yijeongsoo/Smart_Bookstand/SmartBookstand/docs/schematic.pdf

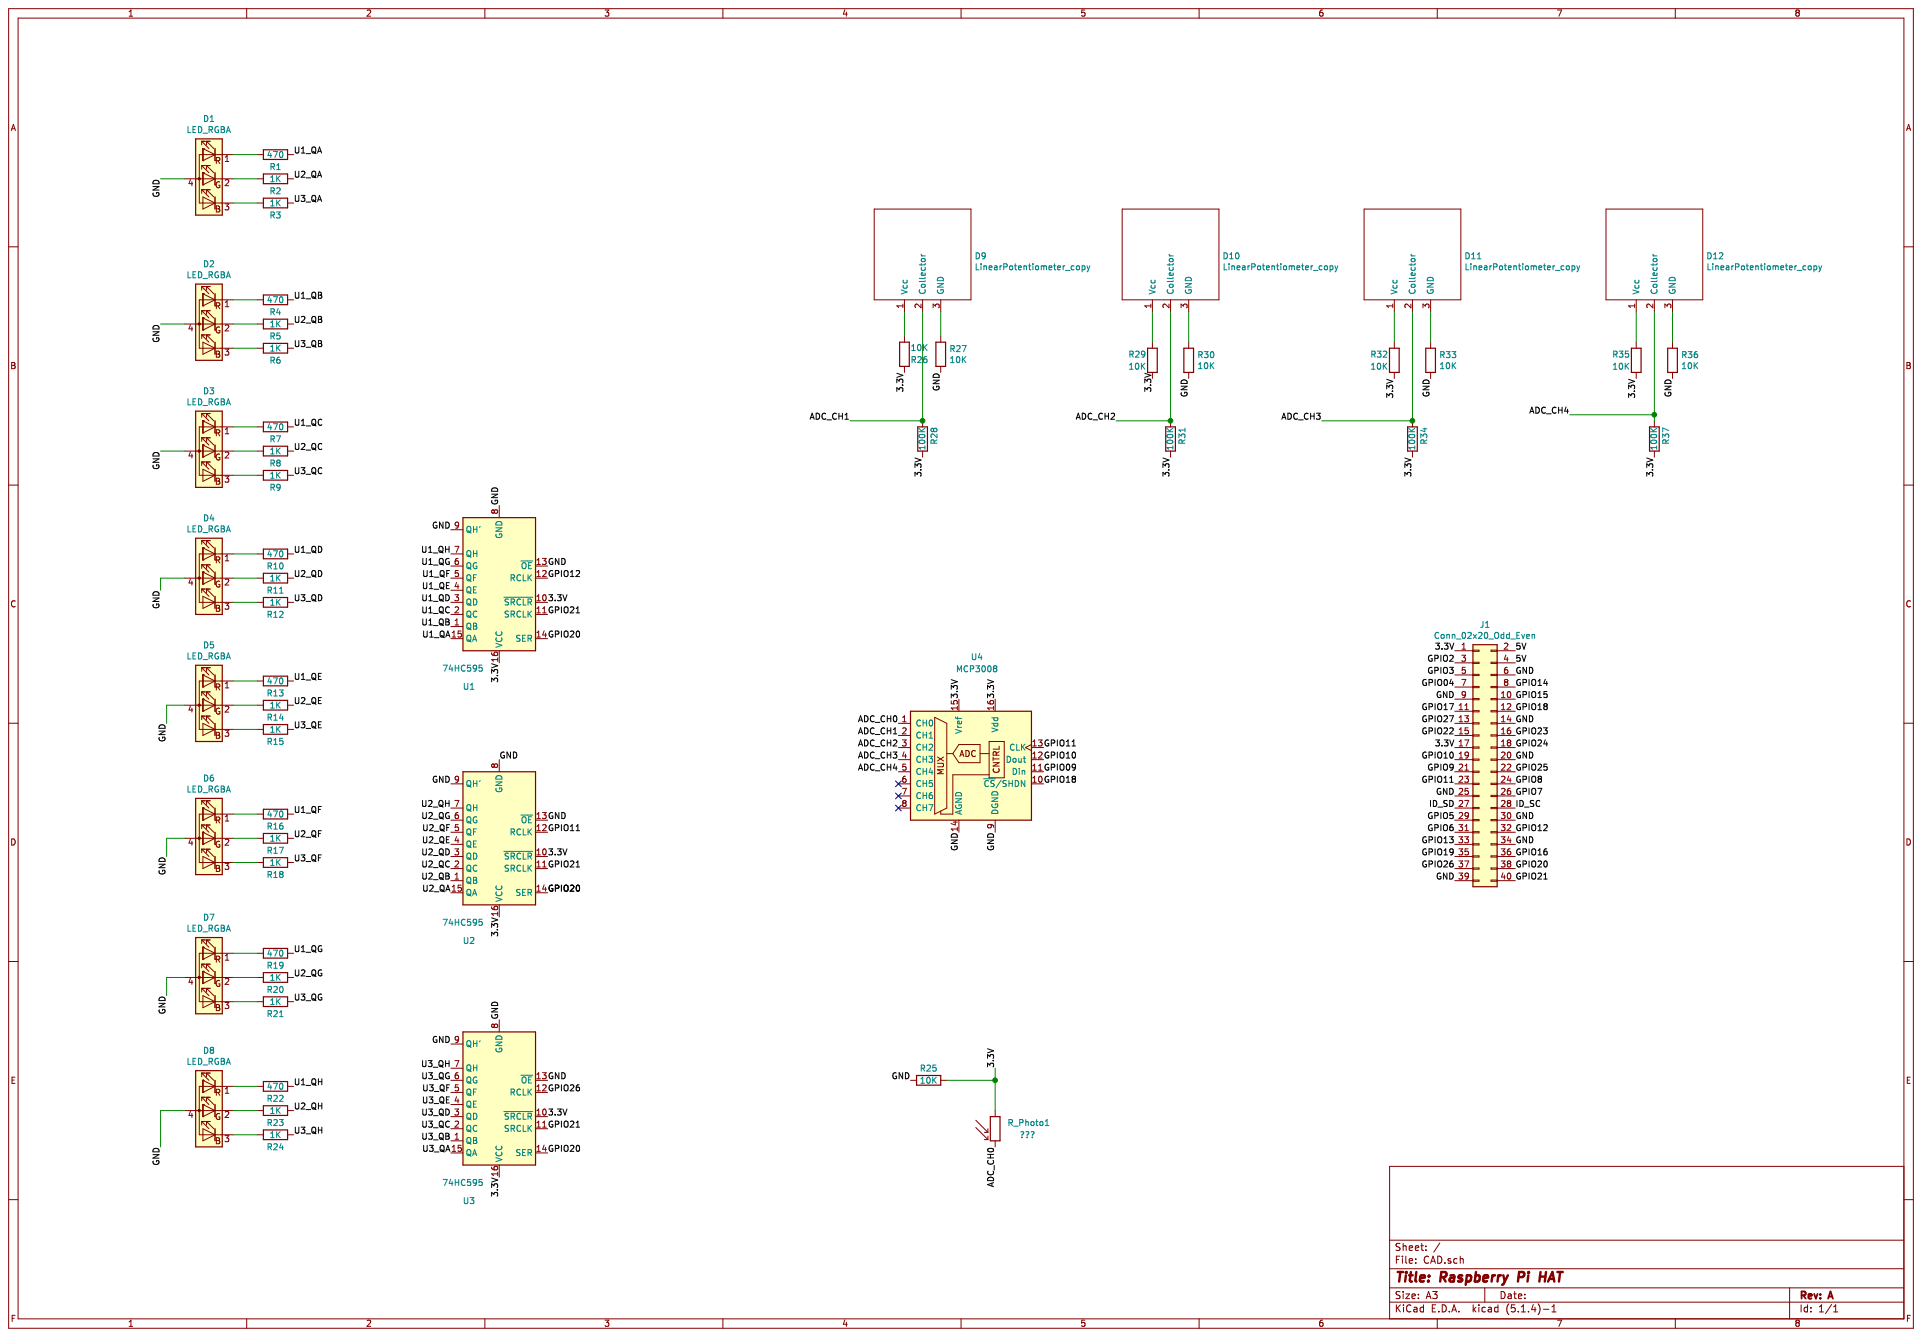
[picture p34: page 1]
