yijeongsoo/Smart_Bookstand/SmartBookstand/docs/Breadboard Diagram.pdf

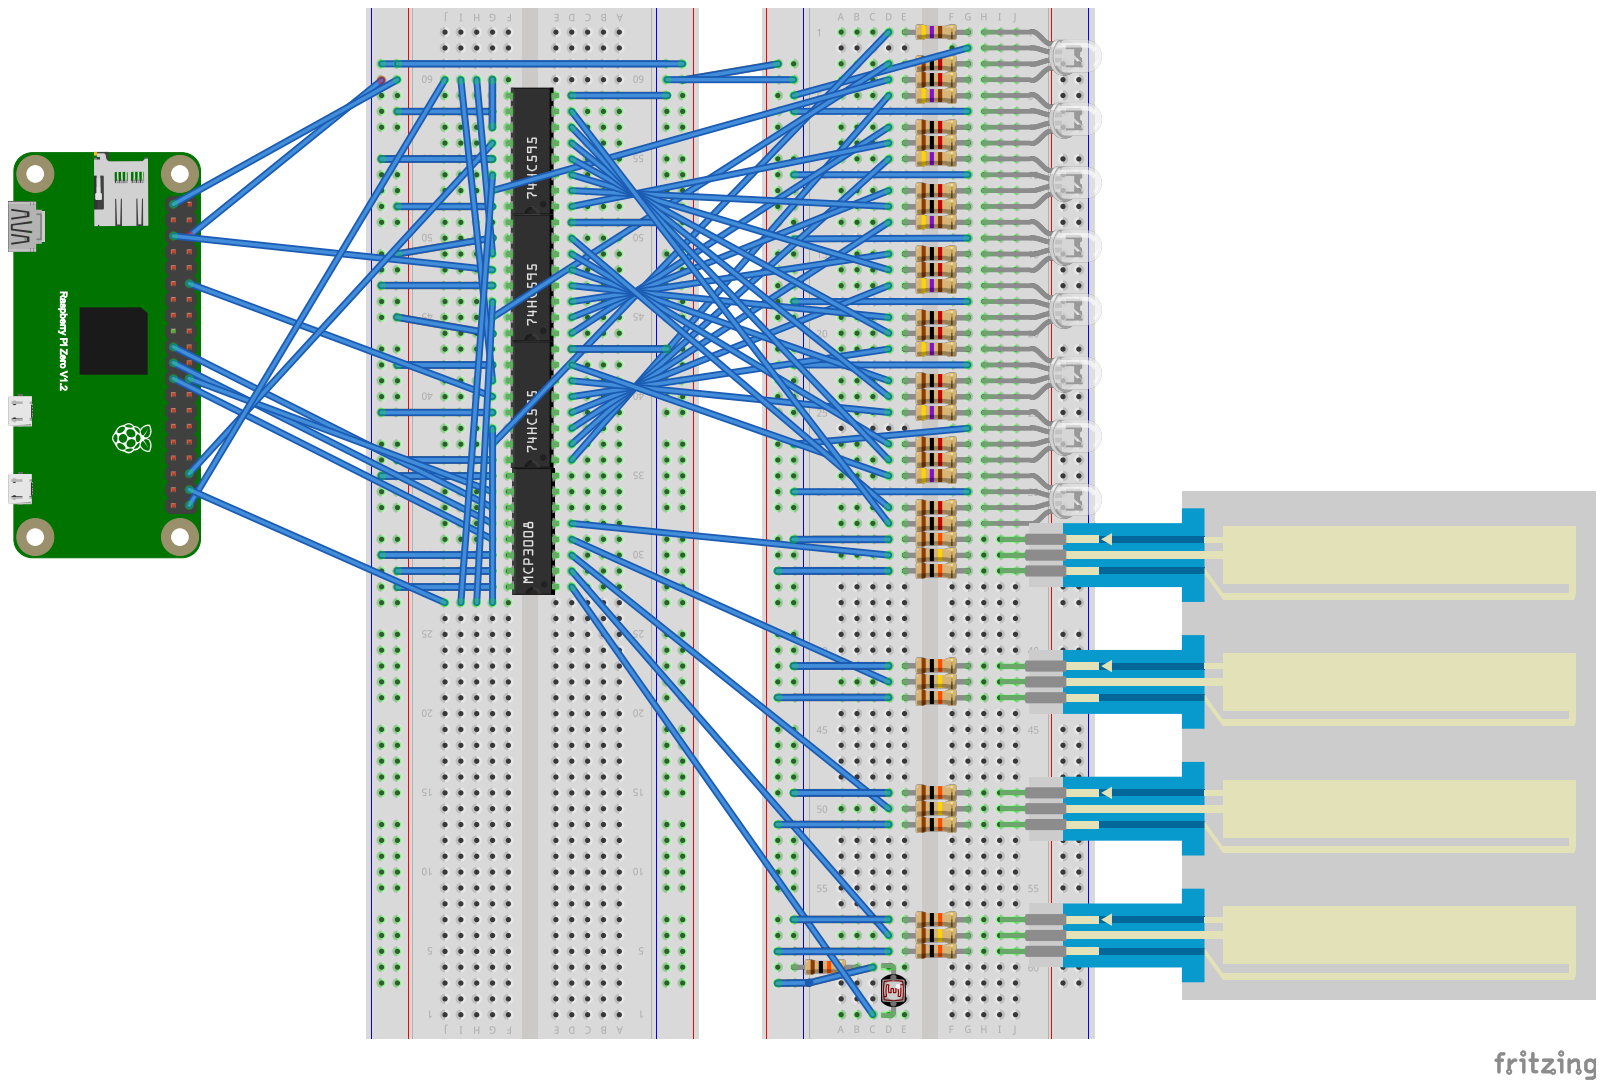
[picture p35: page 1]
