yijeongsoo/Smart_Bookstand/SmartBookstand/docs/pcb_bottom.pdf

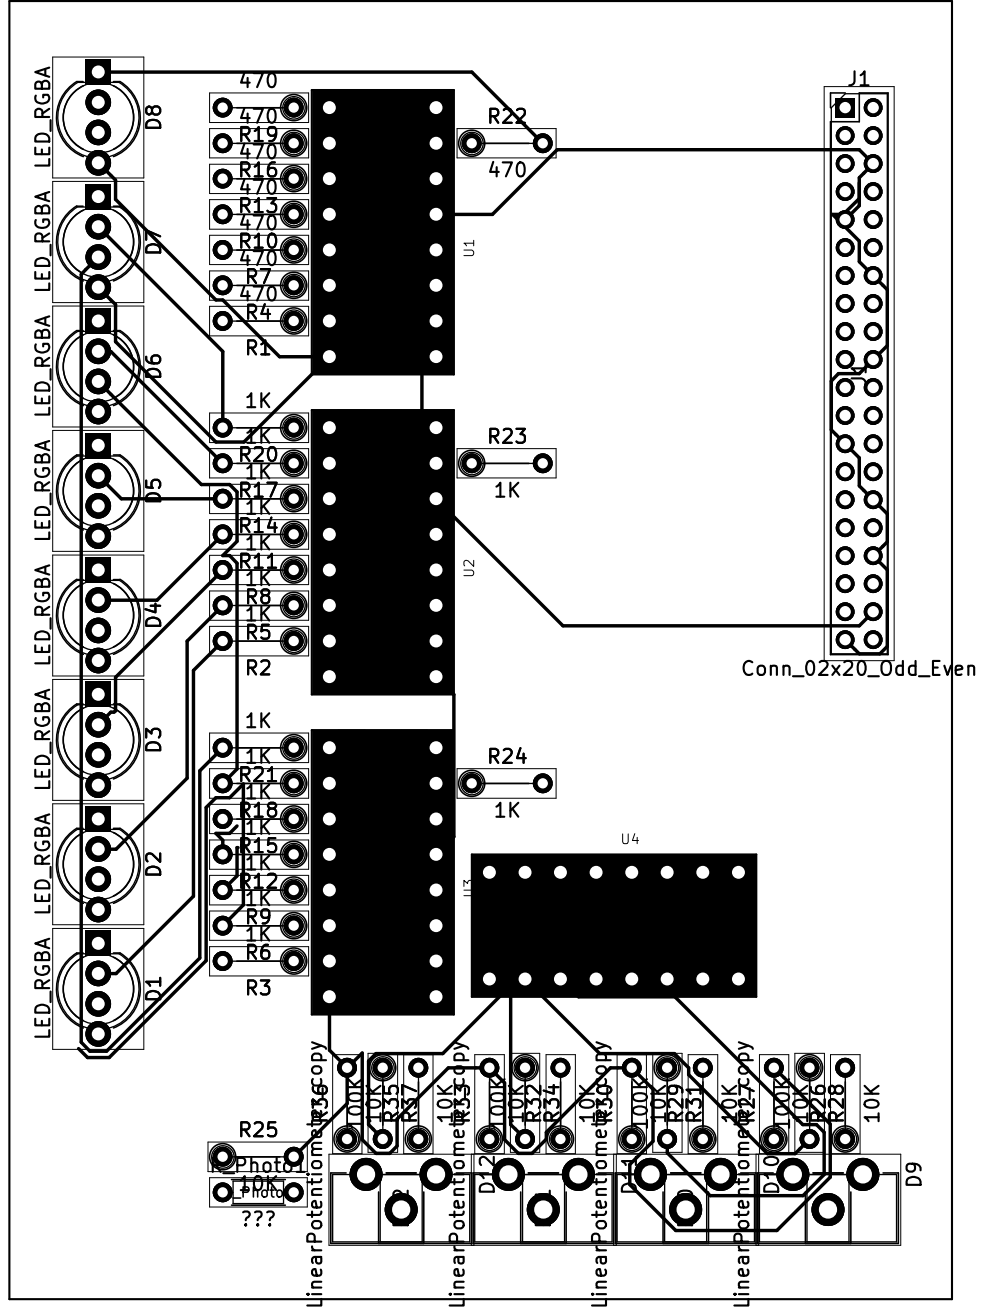
[picture p36: page 1]
