yijeongsoo/Smart_Bookstand/SmartBookstand/docs/pcb_top.pdf

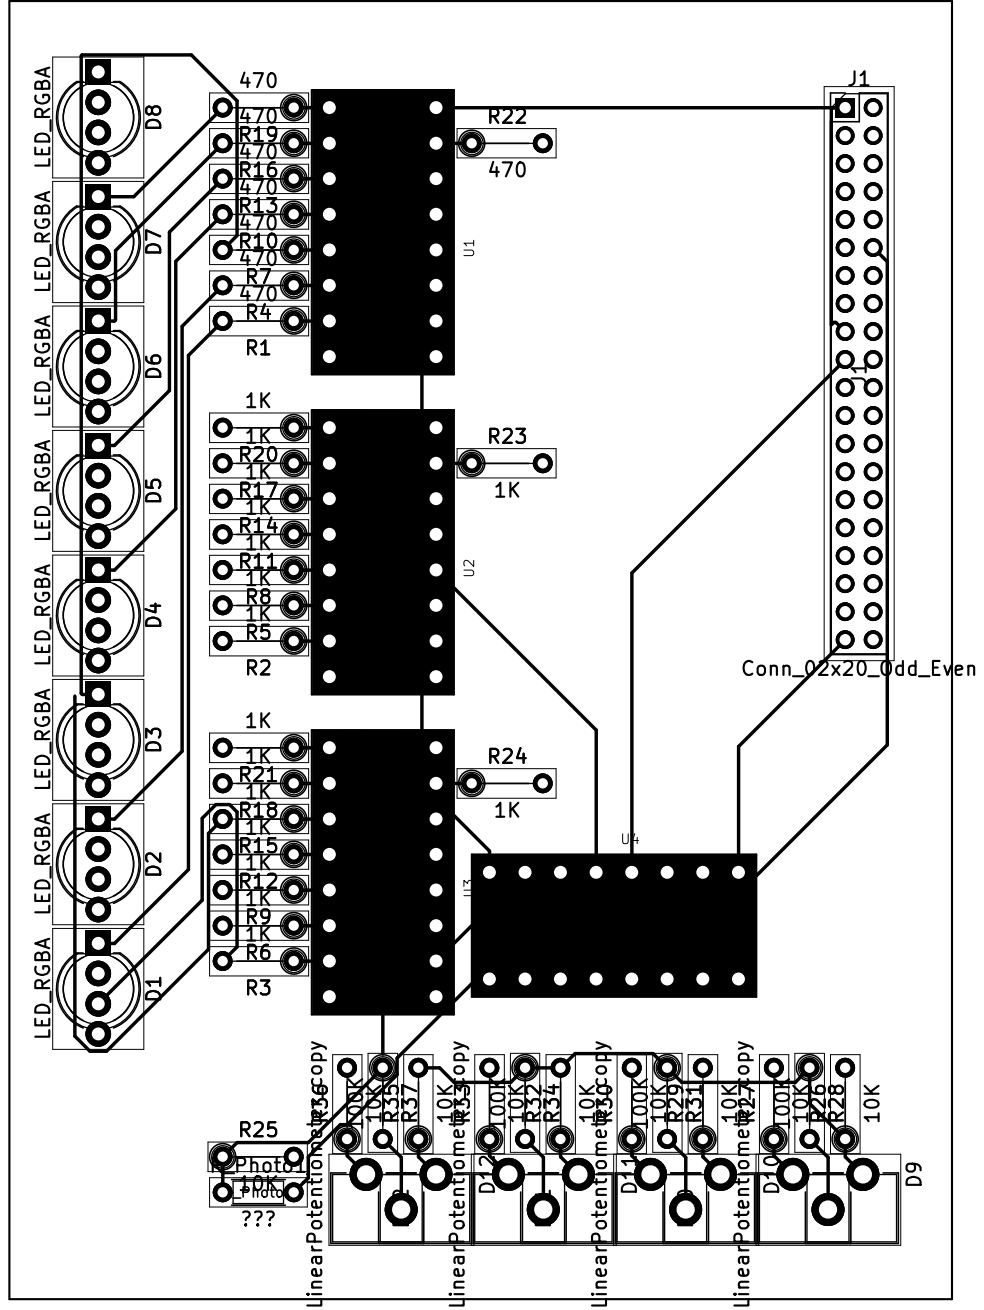
[picture p37: page 1]
