yijeongsoo/Smart_Bookstand/(list of files, drawings)

Other design files:
SmartBookstand/docs/Breadboard Diagram.fzz
