yijeongsoo/Smart_Bookstand/SmartBookstand/docs/pcb_design.kicad_pcb

## KiCad design SmartBookstand/docs/pcb_design.kicad_pcb (2020-04-21)

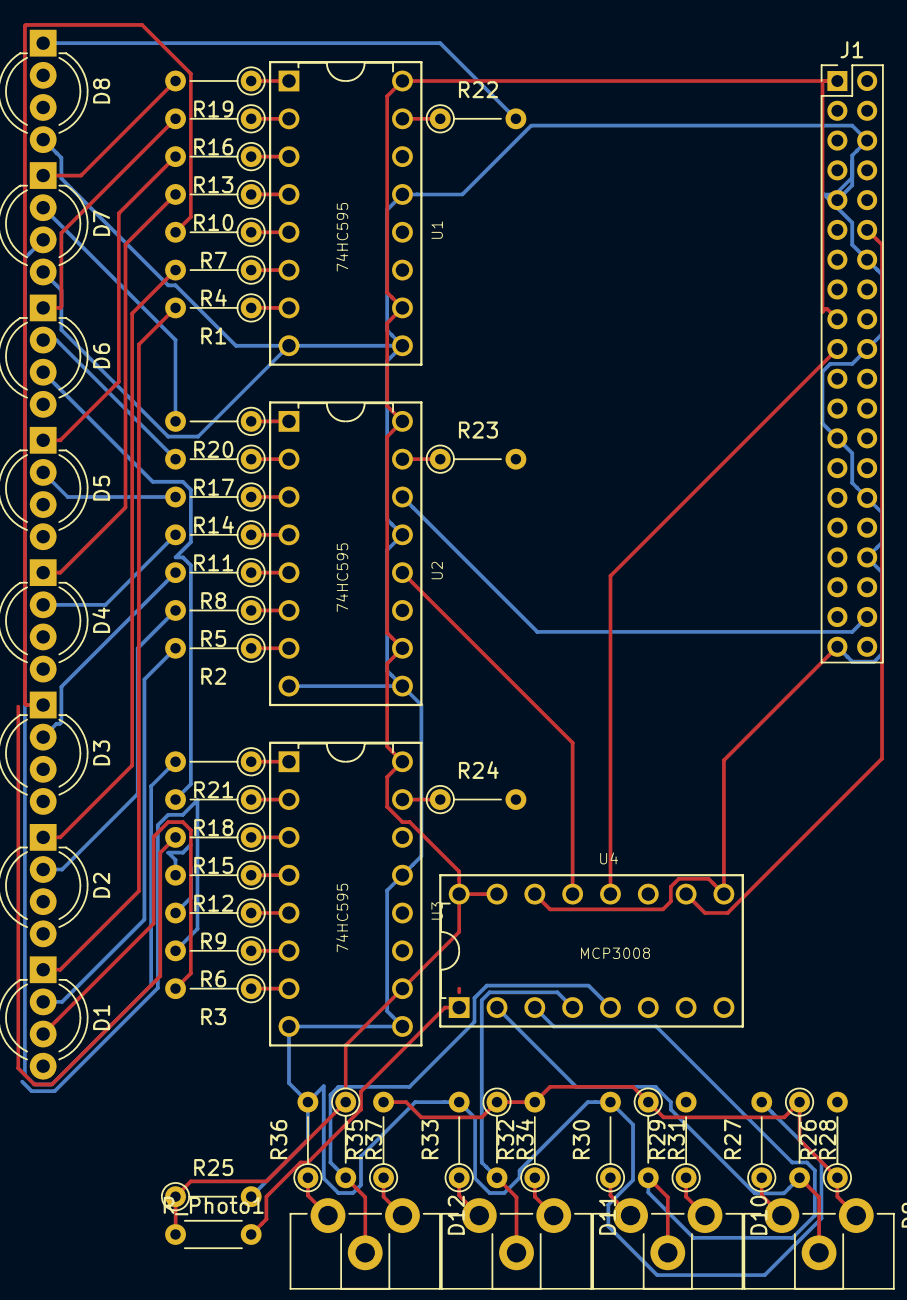
[picture p38: board pcb_design.kicad_pcb from above]

Board: 2 copper layers, 55 parts (0 on the bottom side), 71 nets.

Parts:
D1, D2, D3, D4, D5, D6, D7, D8: LED_RGBA; LED_D5.0mm-4_RGB_Wide_Pins
D9, D10, D11, D12: LinearPotentiometer_copy; Potentiometer_ACP_CA9-H2,5_Horizontal
J1: Conn_02x20_Odd_Even; PinHeader_2x20_P2.00mm_Vertical
R1, R4, R7, R10, R13, R16, R19, R22: 470; R_Axial_DIN0204_L3.6mm_D1.6mm_P5.08mm_Vertical
R2, R3, R5, R6, R8, R9, R11, R12, R14, R15, R17, R18, R20, R21, R23, R24: 1K; R_Axial_DIN0204_L3.6mm_D1.6mm_P5.08mm_Vertical
R25, R26, R27, R29, R30, R32, R33, R35, R36: 10K; R_Axial_DIN0204_L3.6mm_D1.6mm_P5.08mm_Vertical
R28, R31, R34, R37: 100K; R_Axial_DIN0204_L3.6mm_D1.6mm_P5.08mm_Vertical
R_Photo1: ???; R_Axial_DIN0204_L3.6mm_D1.6mm_P5.08mm_Horizontal
U1, U2, U3: 74HC595; DIP16-2.54-19.2X7.62MM
U4: MCP3008; DIP16-2.54-19.2X7.62MM

Connections:
/3.3V: J1.1, J1.17, R25.1, R26.1, R28.1, R31.1, R32.2, R34.1, R35.2, R37.1, R_Photo1.1, U1.10, U1.16, U2.10, U2.16, U3.10, U3.16, U4.15, U4.16
/5V: J1.2, J1.4
/ADC_CH0: R_Photo1.2, U4.1
/ADC_CH1: D9.2, R28.2, U4.2
/ADC_CH2: D10.2, R31.2, U4.3
/ADC_CH3: D11.2, R34.2, U4.4
/ADC_CH4: D12.2, R37.2, U4.5
/GND: D1.4, D2.4, D3.4, D4.4, D5.4, D6.4, D7.4, D8.4, J1.6, J1.9, J1.14, J1.20, J1.25, J1.30, J1.34, J1.39, R25.2, R27.2, R30.2, R33.2, R36.2, U1.8, U1.9, U1.13, U2.8, U2.9, U2.13, U3.8, U3.9, U3.13, U4.9, U4.14
/GPIO10: J1.19, U4.12
/GPIO11: J1.23, U2.12, U4.13
/GPIO12: J1.32, U1.12
/GPIO18: J1.12, U4.10
/GPIO20: J1.38, U1.14, U2.14, U3.14
/GPIO21: J1.40, U1.11, U2.11, U3.11
/GPIO26: J1.37, U3.12
/U1_QA: R1.1, U1.15
/U1_QB: R4.1, U1.1
/U1_QC: R7.1, U1.2
/U1_QD: R10.1, U1.3
/U1_QE: R13.1, U1.4
/U1_QF: R16.1, U1.5
/U1_QG: R19.1, U1.6
/U1_QH: R22.1, U1.7
/U2_QA: R2.1, U2.15
/U2_QB: R5.1, U2.1
/U2_QC: R8.1, U2.2
/U2_QD: R11.1, U2.3
/U2_QE: R14.1, U2.4
/U2_QF: R17.1, U2.5
/U2_QG: R20.1, U2.6
/U2_QH: R23.1, U2.7
/U3_QA: R3.1, U3.15
/U3_QB: R6.1, U3.1
/U3_QC: R9.1, U3.2
/U3_QD: R12.1, U3.3
/U3_QE: R15.1, U3.4
/U3_QF: R18.1, U3.5
/U3_QG: R21.1, U3.6
/U3_QH: R24.1, U3.7
unnamed: D1.1, R1.2
unnamed: D1.2, R2.2
unnamed: D1.3, R3.2
unnamed: D2.1, R4.2
unnamed: D2.2, R5.2
unnamed: D2.3, R6.2
unnamed: D3.1, R7.2
unnamed: D3.2, R8.2
unnamed: D3.3, R9.2
unnamed: D4.1, R10.2
unnamed: D4.2, R11.2
unnamed: D4.3, R12.2
unnamed: D5.1, R13.2
unnamed: D5.2, R14.2
unnamed: D5.3, R15.2
unnamed: D6.1, R16.2
unnamed: D6.2, R17.2
unnamed: D6.3, R18.2
unnamed: D7.1, R19.2
unnamed: D7.2, R20.2
unnamed: D7.3, R21.2
unnamed: D8.1, R22.2
unnamed: D8.2, R23.2
unnamed: D8.3, R24.2
unnamed: D9.1, R26.2
unnamed: D9.3, R27.1
unnamed: D10.1, R29.1
unnamed: D10.3, R30.1
unnamed: D11.1, R32.1
unnamed: D11.3, R33.1
unnamed: D12.1, R35.1
unnamed: D12.3, R36.1
